KrazTech/SCAN2000-NO-MCU/images/Logic-Controlled.PNG

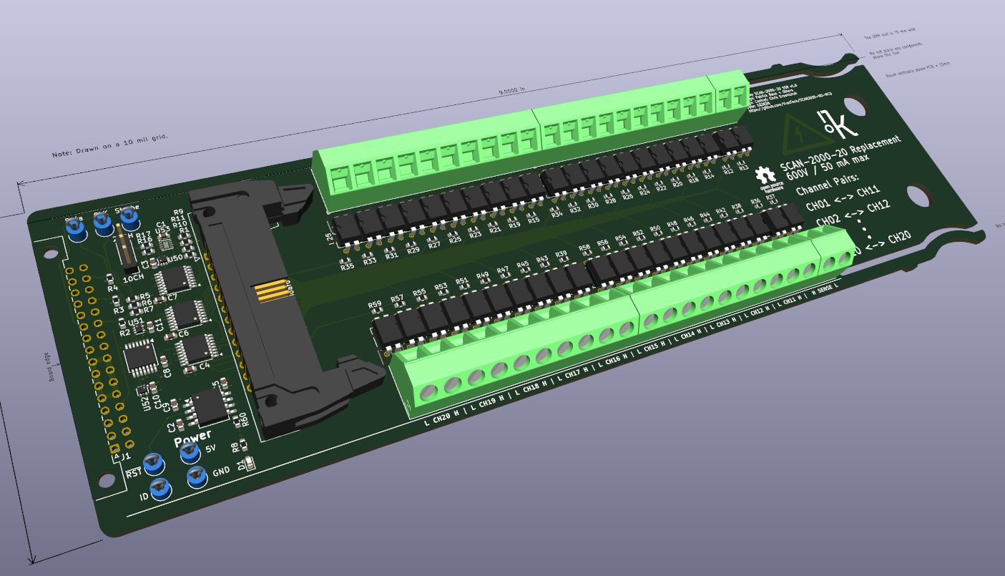
images/Logic-Controlled.PNG
