KrazTech/SCAN2000-NO-MCU/main.kicad_pcb

## KiCad design main.kicad_pcb (2026-03-02)

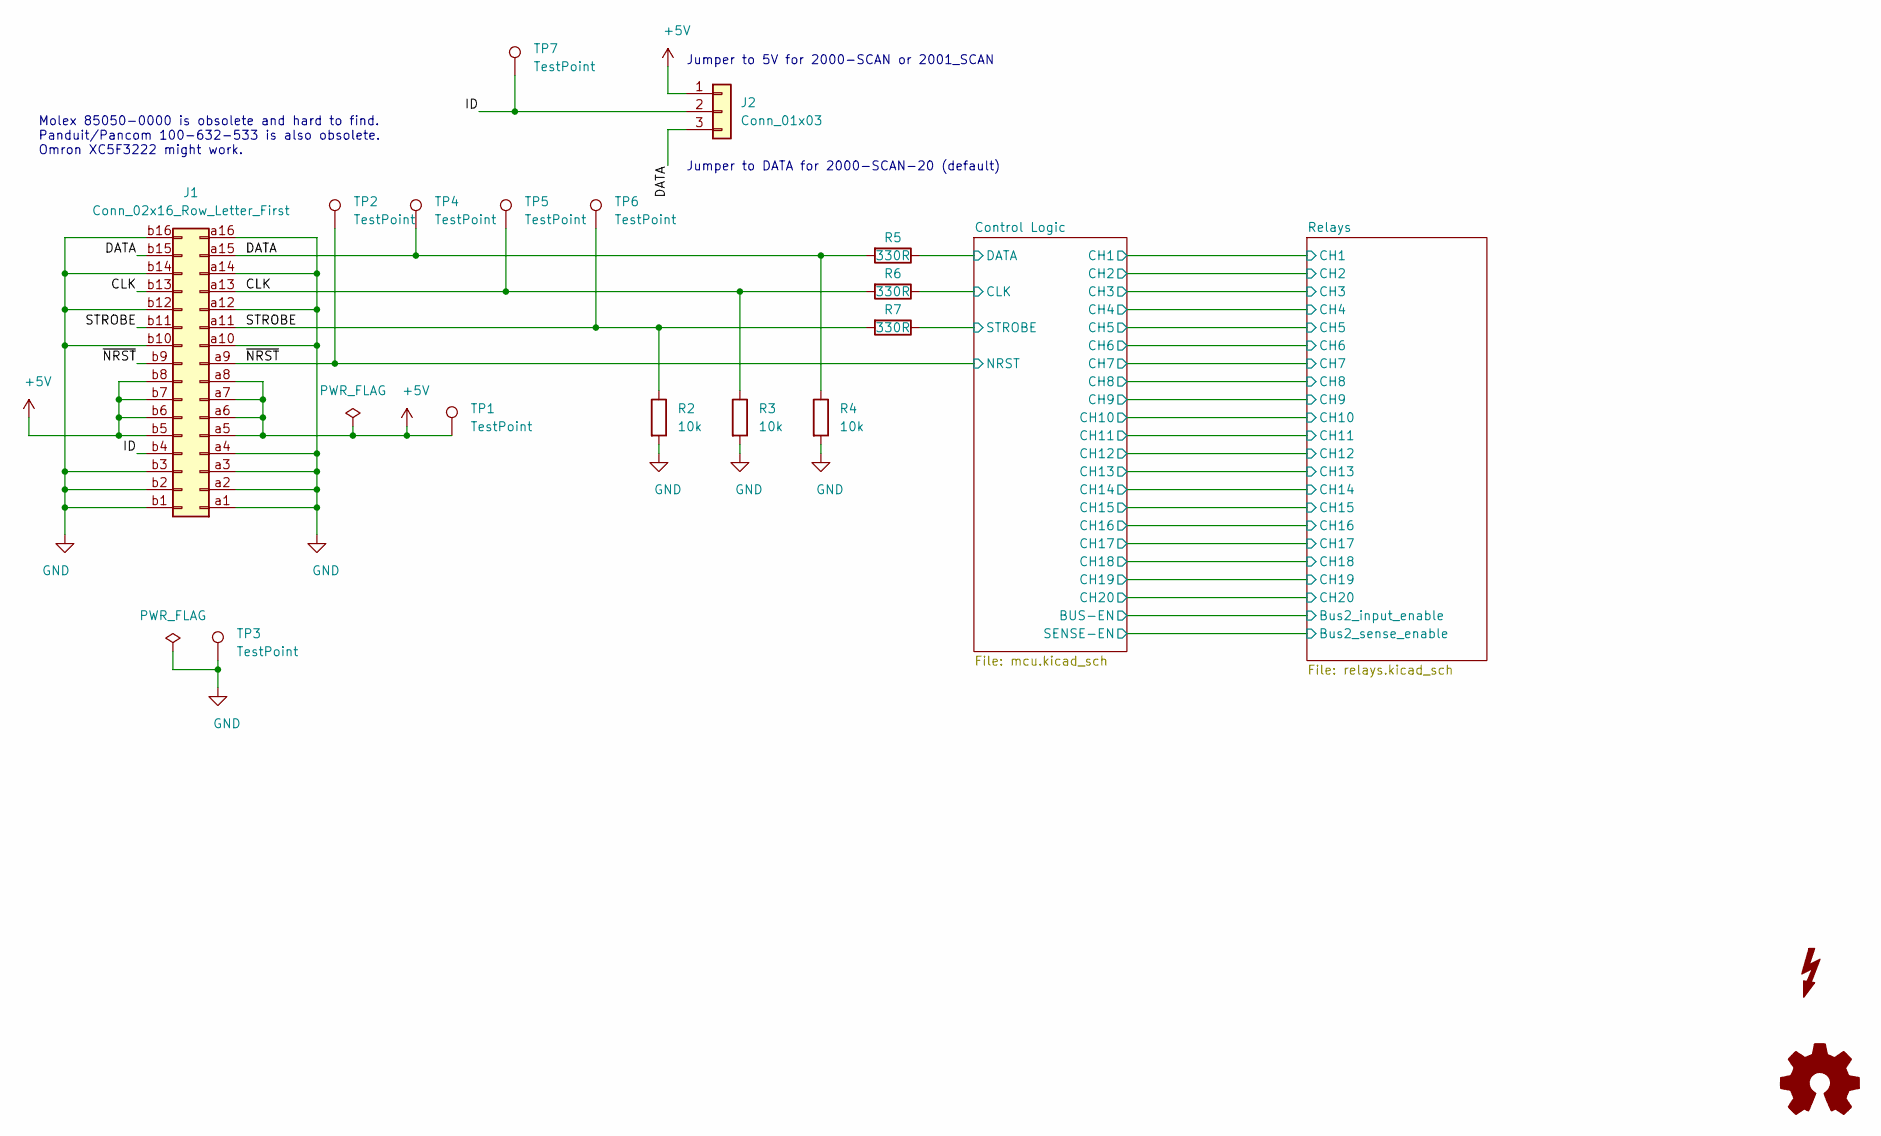
[picture p2: schematic main.kicad_sch, Keithley 2000-SCAN-20 SSR]

Parts:
J1: Conn_02x16_Row_Letter_First; DIN41612_B2_2x16_Male_Horizontal_THT
J2: Conn_01x03; PinHeader_1x03_P2.54mm_Vertical
LOGO2: Logo_Open_Hardware_Small; OSHW-Logo_7.5x8mm_SilkScreen
R2, R3, R4: 10k; R_0603_1608Metric
R5, R6, R7: 330R; R_0603_1608Metric
SYM1: SYM_Flash_Small; Symbol_Highvoltage_Type2_CopperTop_Small
TP1, TP2, TP3, TP4, TP5, TP6, TP7: TestPoint; TestPoint_Loop_D2.60mm_Drill1.6mm_Beaded

Connections:
+5V: J1.a5, J1.a6, J1.a7, J1.a8, J1.b5, J1.b6, J1.b7, J1.b8, J2.1, TP1.1; also elsewhere on the board
/CLK: J1.a13, J1.b13, R3.1, R6.2, TP5.1
/Control Logic/CLK: R6.1; also elsewhere on the board
/Control Logic/DATA: R5.1; also elsewhere on the board
/Control Logic/STROBE: R7.1; also elsewhere on the board
/DATA: J1.a15, J1.b15, J2.3, R4.1, R5.2, TP4.1
/ID: J1.b4, J2.2, TP7.1
/STROBE: J1.a11, J1.b11, R2.1, R7.2, TP6.1
/~NRST: J1.a9, J1.b9, TP2.1; also elsewhere on the board
GND: J1.a1, J1.a2, J1.a3, J1.a4, J1.a10, J1.a12, J1.a14, J1.a16, J1.b1, J1.b2, J1.b3, J1.b10, J1.b12, J1.b14, J1.b16, R2.2, R3.2, R4.2, TP3.1; also elsewhere on the board

Notes on the sheet:
Jumper to 5V for 2000-SCAN or 2001_SCAN
Molex 85050-0000 is obsolete and hard to find. Panduit/Pancom 100-632-533 is also obsolete. Omron XC5F3222 might work.
Jumper to DATA for 2000-SCAN-20 (default)

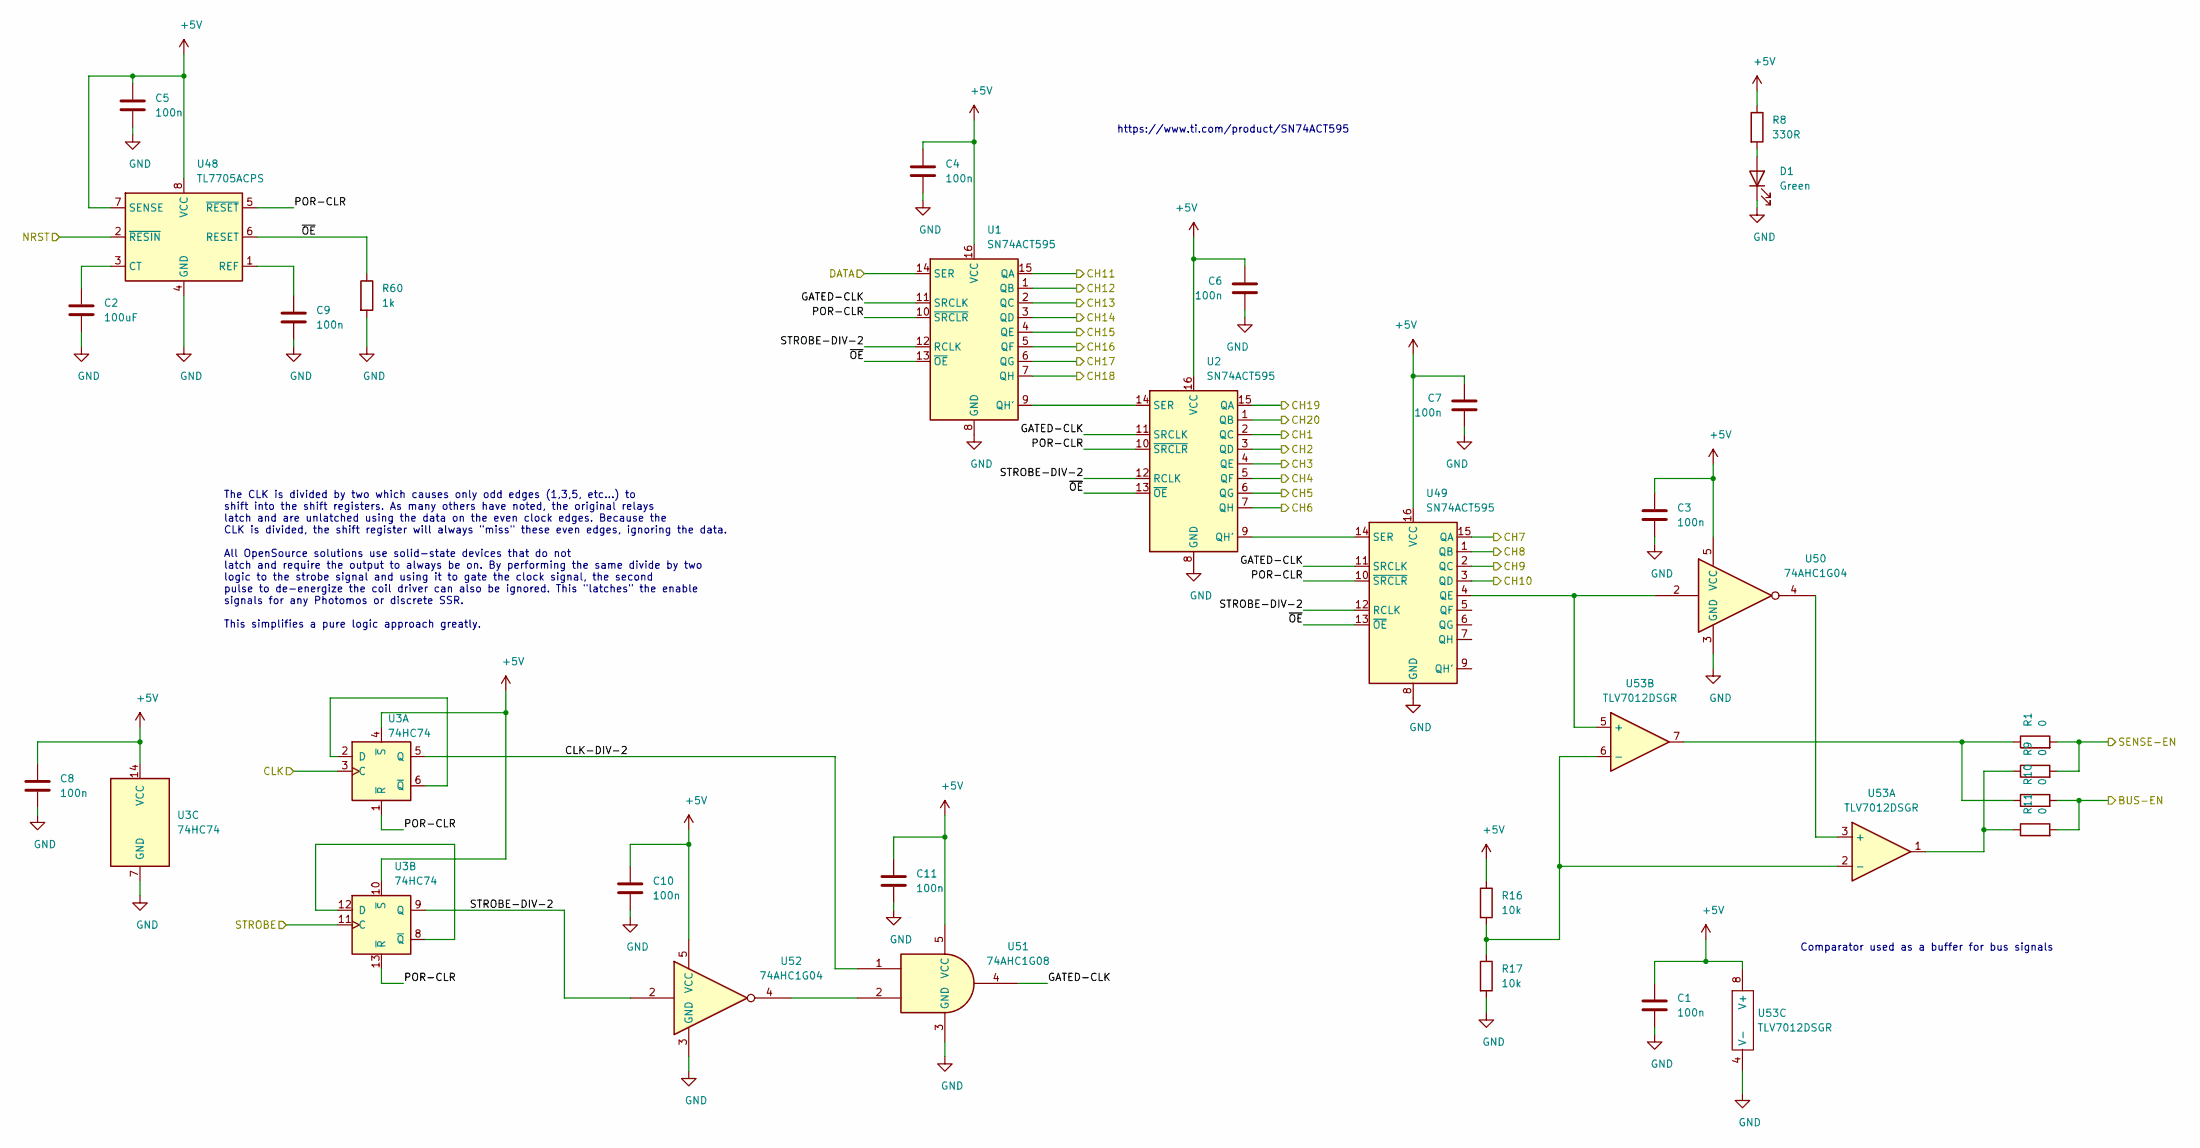
[picture p3: schematic mcu.kicad_sch, Keithley 2000-SCAN-20 SSR]

Parts:
C1, C3, C4, C5, C6, C7, C8, C9, C10, C11: 100n; C_0603_1608Metric
C2: 100uF; C_0603_1608Metric
D1: Green; LED_0603_1608Metric
R1, R9, R10, R11: 0; R_0603_1608Metric
R8: 330R; R_0603_1608Metric
R16, R17: 10k; R_0603_1608Metric
R60: 1k; R_0603_1608Metric
U1, U2, U49: SN74ACT595; TSSOP-16_4.4x5mm_P0.65mm
U3: 74HC74; TSSOP-14_4.4x5mm_P0.65mm
U48: TL7705ACPS; SOIC-8_5.3x6.2mm_P1.27mm
U50, U52: 74AHC1G04; SOT-553
U51: 74AHC1G08; SOT-553
U53: TLV7012DSGR; Texas_DSG0008A_WSON-8-1EP_2x2mm_P0.5mm_EP0.9x1.6mm_ThermalV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

Connections:
+5V: C1.1, C3.1, C4.1, C5.1, C6.1, C7.1, C8.1, C10.1, C11.1, R8.1, R16.1, U1.16 (VCC), U2.16 (VCC), U3.4 (~S), U3.10 (~S), U3.14 (VCC), U48.7 (SENSE), U48.8 (VCC), U49.16 (VCC), U50.5 (VCC), U51.5 (VCC), U52.5 (VCC), U53.8 (V+); also elsewhere on the board
/Control Logic/BUS-EN: R10.2, R11.2; also elsewhere on the board
/Control Logic/CH1: U2.2 (QC); also elsewhere on the board
/Control Logic/CH2: U2.3 (QD); also elsewhere on the board
/Control Logic/CH3: U2.4 (QE); also elsewhere on the board
/Control Logic/CH4: U2.5 (QF); also elsewhere on the board
/Control Logic/CH5: U2.6 (QG); also elsewhere on the board
/Control Logic/CH6: U2.7 (QH); also elsewhere on the board
/Control Logic/CH7: U49.15 (QA); also elsewhere on the board
/Control Logic/CH8: U49.1 (QB); also elsewhere on the board
/Control Logic/CH9: U49.2 (QC); also elsewhere on the board
/Control Logic/CH10: U49.3 (QD); also elsewhere on the board
/Control Logic/CH11: U1.15 (QA); also elsewhere on the board
/Control Logic/CH12: U1.1 (QB); also elsewhere on the board
/Control Logic/CH13: U1.2 (QC); also elsewhere on the board
/Control Logic/CH14: U1.3 (QD); also elsewhere on the board
/Control Logic/CH15: U1.4 (QE); also elsewhere on the board
/Control Logic/CH16: U1.5 (QF); also elsewhere on the board
/Control Logic/CH17: U1.6 (QG); also elsewhere on the board
/Control Logic/CH18: U1.7 (QH); also elsewhere on the board
/Control Logic/CH19: U2.15 (QA); also elsewhere on the board
/Control Logic/CH20: U2.1 (QB); also elsewhere on the board
/Control Logic/CLK: U3.3 (C); also elsewhere on the board
/Control Logic/CLK-DIV-2: U3.5 (Q), U51.1
/Control Logic/DATA: U1.14 (SER); also elsewhere on the board
/Control Logic/GATED-CLK: U1.11 (SRCLK), U2.11 (SRCLK), U49.11 (SRCLK), U51.4
/Control Logic/POR-CLR: U1.10 (~SRCLR), U2.10 (~SRCLR), U3.1 (~R), U3.13 (~R), U48.5 (~RESET), U49.10 (~SRCLR)
/Control Logic/SENSE-EN: R1.2, R9.2; also elsewhere on the board
/Control Logic/STROBE: U3.11 (C); also elsewhere on the board
/Control Logic/STROBE-DIV-2: U1.12 (RCLK), U2.12 (RCLK), U3.9 (Q), U49.12 (RCLK), U52.2
/Control Logic/~OE: R60.1, U1.13 (~OE), U2.13 (~OE), U48.6 (RESET), U49.13 (~OE)
/~NRST: U48.2 (~RESIN); also elsewhere on the board
GND: C1.2, C2.2, C3.2, C4.2, C5.2, C6.2, C7.2, C8.2, C9.2, C10.2, C11.2, D1.1 (K), R17.2, R60.2, U1.8 (GND), U2.8 (GND), U3.7 (GND), U48.4 (GND), U49.8 (GND), U50.3 (GND), U51.3 (GND), U52.3 (GND), U53.4 (V-); also elsewhere on the board
unnamed: D1.2 (A), R8.2
unnamed: R1.1, R10.1, U53.7
unnamed: R9.1, R11.1, U53.1
unnamed: U1.9 (QH'), U2.14 (SER)
unnamed: U2.9 (QH'), U49.14 (SER)
unnamed: U3.2 (D), U3.6 (~Q)
unnamed: U3.8 (~Q), U3.12 (D)
unnamed: C2.1, U48.3 (CT)
unnamed: C9.1, U48.1 (REF)
unnamed: U49.4 (QE), U50.2, U53.5 (+)
unnamed: U51.2, U52.4
unnamed: U50.4, U53.3 (+)
unnamed: R16.2, R17.1, U53.2 (-), U53.6 (-)

Notes on the sheet:
The CLK is divided by two which causes only odd edges (1,3,5, etc...) to shift into the shift registers. As many others have noted, the original relays latch and are unlatched using the data on the even clock edges. Because the CLK is divided, the shift register will always "miss" these even edges,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
https://www.ti.com/product/SN74ACT595
Comparator used as a buffer for bus signals

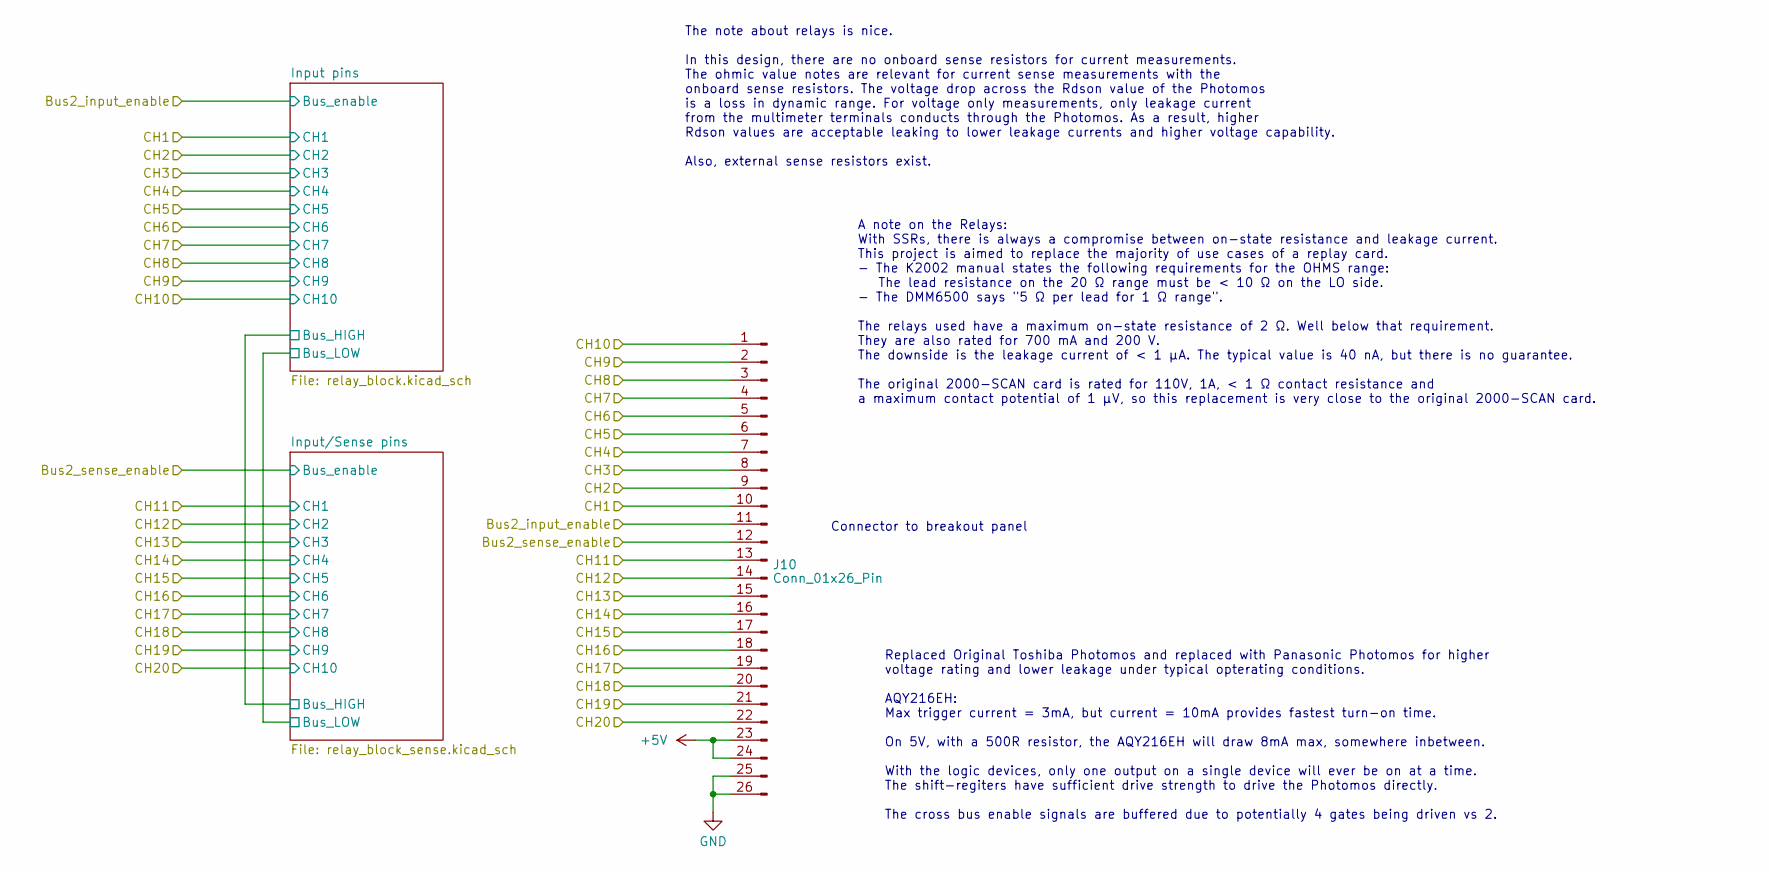
[picture p4: schematic relays.kicad_sch, Keithley 2000-SCAN-20 SSR]

Parts:
J10: Conn_01x26_Pin; IDC-Header_2x13_P2.54mm_Latch_Horizontal

Connections:
+5V: J10.23, J10.24; also elsewhere on the board
/Control Logic/BUS-EN: J10.11; also elsewhere on the board
/Control Logic/CH1: J10.10; also elsewhere on the board
/Control Logic/CH2: J10.9; also elsewhere on the board
/Control Logic/CH3: J10.8; also elsewhere on the board
/Control Logic/CH4: J10.7; also elsewhere on the board
/Control Logic/CH5: J10.6; also elsewhere on the board
/Control Logic/CH6: J10.5; also elsewhere on the board
/Control Logic/CH7: J10.4; also elsewhere on the board
/Control Logic/CH8: J10.3; also elsewhere on the board
/Control Logic/CH9: J10.2; also elsewhere on the board
/Control Logic/CH10: J10.1; also elsewhere on the board
/Control Logic/CH11: J10.13; also elsewhere on the board
/Control Logic/CH12: J10.14; also elsewhere on the board
/Control Logic/CH13: J10.15; also elsewhere on the board
/Control Logic/CH14: J10.16; also elsewhere on the board
/Control Logic/CH15: J10.17; also elsewhere on the board
/Control Logic/CH16: J10.18; also elsewhere on the board
/Control Logic/CH17: J10.19; also elsewhere on the board
/Control Logic/CH18: J10.20; also elsewhere on the board
/Control Logic/CH19: J10.21; also elsewhere on the board
/Control Logic/CH20: J10.22; also elsewhere on the board
/Control Logic/SENSE-EN: J10.12; also elsewhere on the board
GND: J10.25, J10.26; also elsewhere on the board

Notes on the sheet:
A note on the Relays: With SSRs, there is always a compromise between on-state resistance and leakage current. This project is aimed to replace the majority of use cases of a replay card. - The K2002 manual states the following requirements for the OHMS range: The lead resistance on the 20 Ω range 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
Replaced Original Toshiba Photomos and replaced with Panasonic Photomos for higher voltage rating and lower leakage under typical opterating conditions. AQY216EH: Max trigger current = 3mA, but current = 10mA provides fastest turn-on time. On 5V, with a 500R resistor, the AQY216EH will draw 8mA max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
The note about relays is nice. In this design, there are no onboard sense resistors for current measurements. The ohmic value notes are relevant for current sense measurements with the onboard sense resistors. The voltage drop across the Rdson value of the Photomos is a loss in dynamic range. For v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
Connector to breakout panel

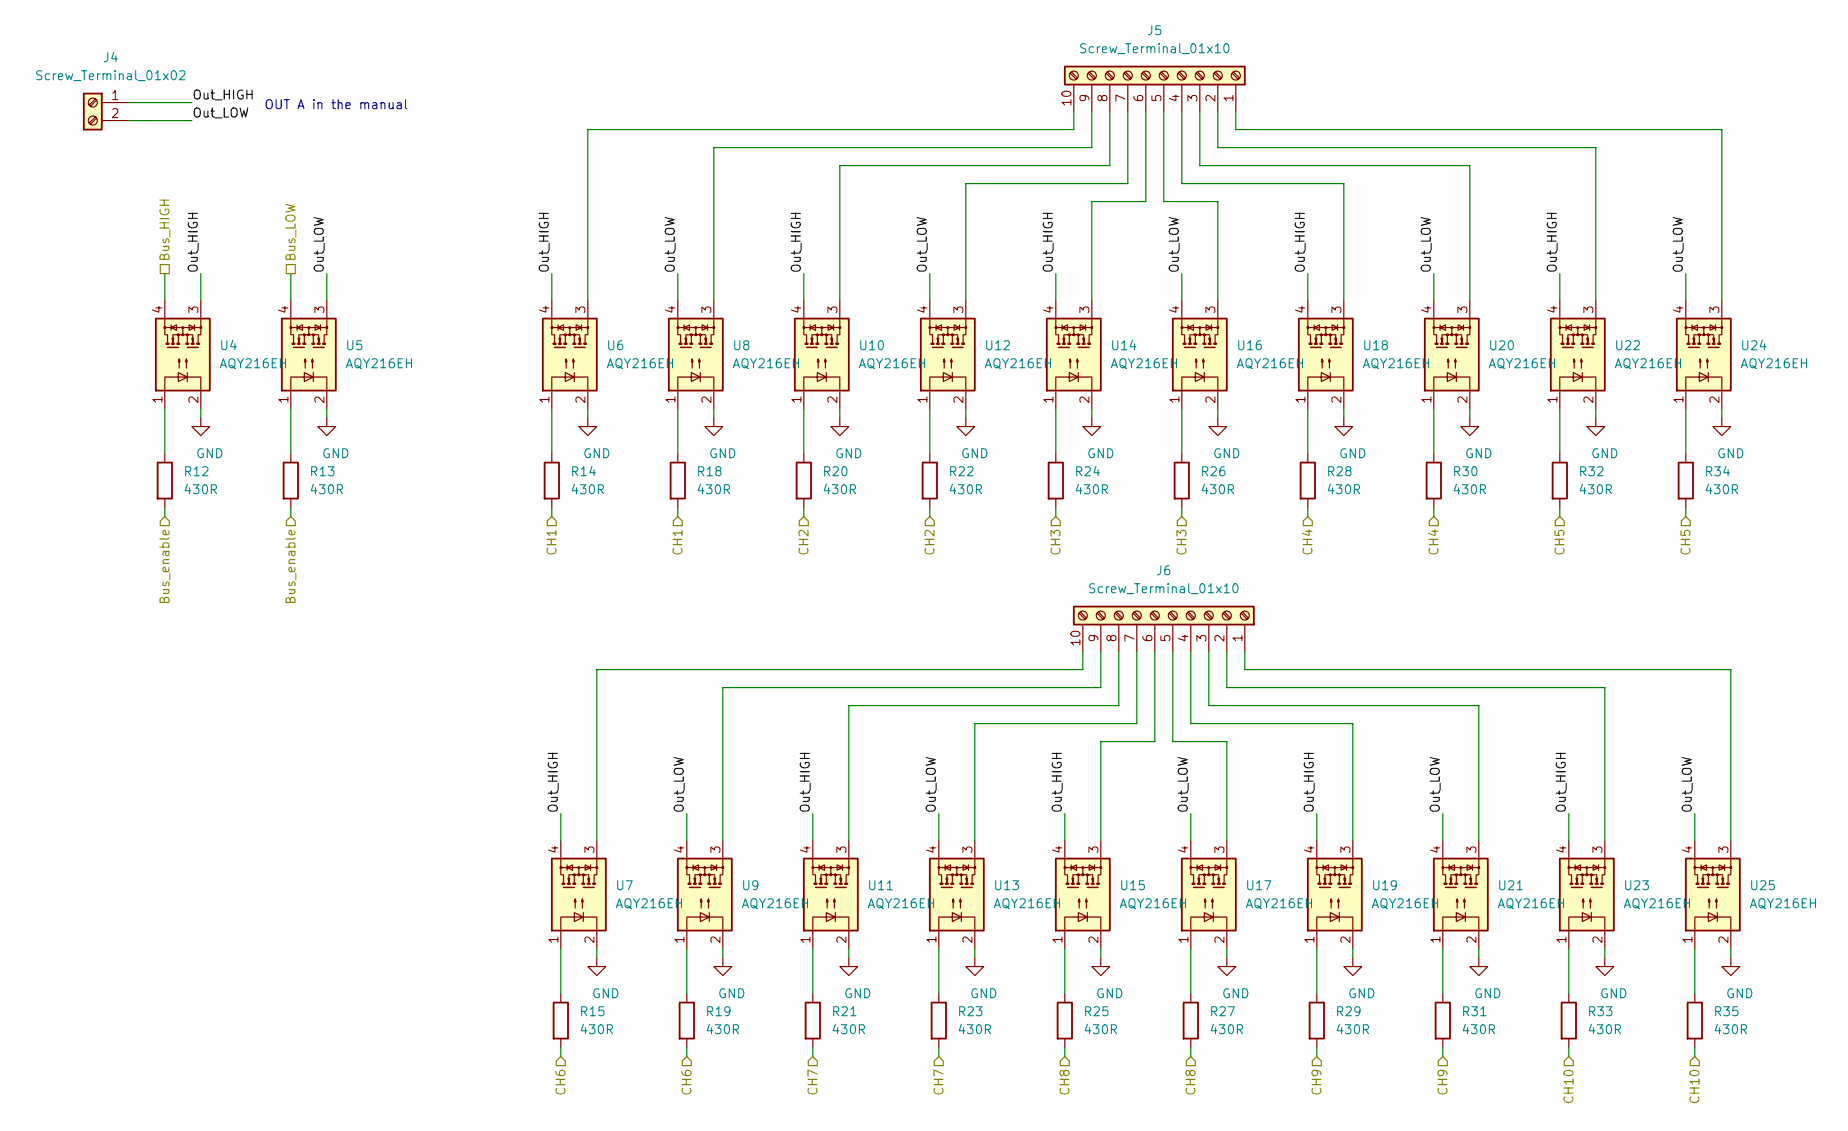
[picture p5: schematic relay_block.kicad_sch, Keithley 2000-SCAN-20 SSR]

Parts:
J4: Screw_Terminal_01x02; TerminalBlock_Phoenix_SMKDSN-1,5-2-5.08_1x02_P5.08mm_Horizo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
J5, J6: Screw_Terminal_01x10; TerminalBlock_Phoenix_SMKDSN-1,5-10-5.08_1x10_P5.08mm_Horiz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
R12, R13, R14, R15, R18, R19, R20, R21, R22, R23, R24, R25, R26, R27, R28, R29, R30, R31, R32, R33, R34, R35: 430R; R_0603_1608Metric
U4, U5, U6, U7, U8, U9, U10, U11, U12, U13, U14, U15, U16, U17, U18, U19, U20, U21, U22, U23, U24, U25: AQY216EH; DIP-4_W7.62mm_Least

Connections:
/Control Logic/BUS-EN: R12.2, R13.2; also elsewhere on the board
/Control Logic/CH1: R14.2, R18.2; also elsewhere on the board
/Control Logic/CH2: R20.2, R22.2; also elsewhere on the board
/Control Logic/CH3: R24.2, R26.2; also elsewhere on the board
/Control Logic/CH4: R28.2, R30.2; also elsewhere on the board
/Control Logic/CH5: R32.2, R34.2; also elsewhere on the board
/Control Logic/CH6: R15.2, R19.2; also elsewhere on the board
/Control Logic/CH7: R21.2, R23.2; also elsewhere on the board
/Control Logic/CH8: R25.2, R27.2; also elsewhere on the board
/Control Logic/CH9: R29.2, R31.2; also elsewhere on the board
/Control Logic/CH10: R33.2, R35.2; also elsewhere on the board
/Relays/Input pins/Bus_HIGH: U4.4; also elsewhere on the board
/Relays/Input pins/Bus_LOW: U5.4; also elsewhere on the board
/Relays/Input pins/Out_HIGH: J4.1, U4.3, U6.4, U7.4, U10.4, U11.4, U14.4, U15.4, U18.4, U19.4, U22.4, U23.4
/Relays/Input pins/Out_LOW: J4.2, U5.3, U8.4, U9.4, U12.4, U13.4, U16.4, U17.4, U20.4, U21.4, U24.4, U25.4
GND: U4.2, U5.2, U6.2, U7.2, U8.2, U9.2, U10.2, U11.2, U12.2, U13.2, U14.2, U15.2, U16.2, U17.2, U18.2, U19.2, U20.2, U21.2, U22.2, U23.2, U24.2, U25.2; also elsewhere on the board
unnamed: J5.1, U24.3
unnamed: J5.2, U22.3
unnamed: J5.3, U20.3
unnamed: J5.4, U18.3
unnamed: J5.5, U16.3
unnamed: J5.6, U14.3
unnamed: J5.7, U12.3
unnamed: J5.8, U10.3
unnamed: J5.9, U8.3
unnamed: J5.10, U6.3
unnamed: J6.1, U25.3
unnamed: J6.2, U23.3
unnamed: J6.3, U21.3
unnamed: J6.4, U19.3
unnamed: J6.5, U17.3
unnamed: J6.6, U15.3
unnamed: J6.7, U13.3
unnamed: J6.8, U11.3
unnamed: J6.9, U9.3
unnamed: J6.10, U7.3
unnamed: R12.1, U4.1
unnamed: R13.1, U5.1
unnamed: R14.1, U6.1
unnamed: R15.1, U7.1
unnamed: R18.1, U8.1
unnamed: R19.1, U9.1
unnamed: R20.1, U10.1
unnamed: R21.1, U11.1
unnamed: R22.1, U12.1
unnamed: R23.1, U13.1
unnamed: R24.1, U14.1
unnamed: R25.1, U15.1
unnamed: R26.1, U16.1
unnamed: R27.1, U17.1
unnamed: R28.1, U18.1
unnamed: R29.1, U19.1
unnamed: R30.1, U20.1
unnamed: R31.1, U21.1
unnamed: R32.1, U22.1
unnamed: R33.1, U23.1
unnamed: R34.1, U24.1
unnamed: R35.1, U25.1

Notes on the sheet:
OUT A in the manual

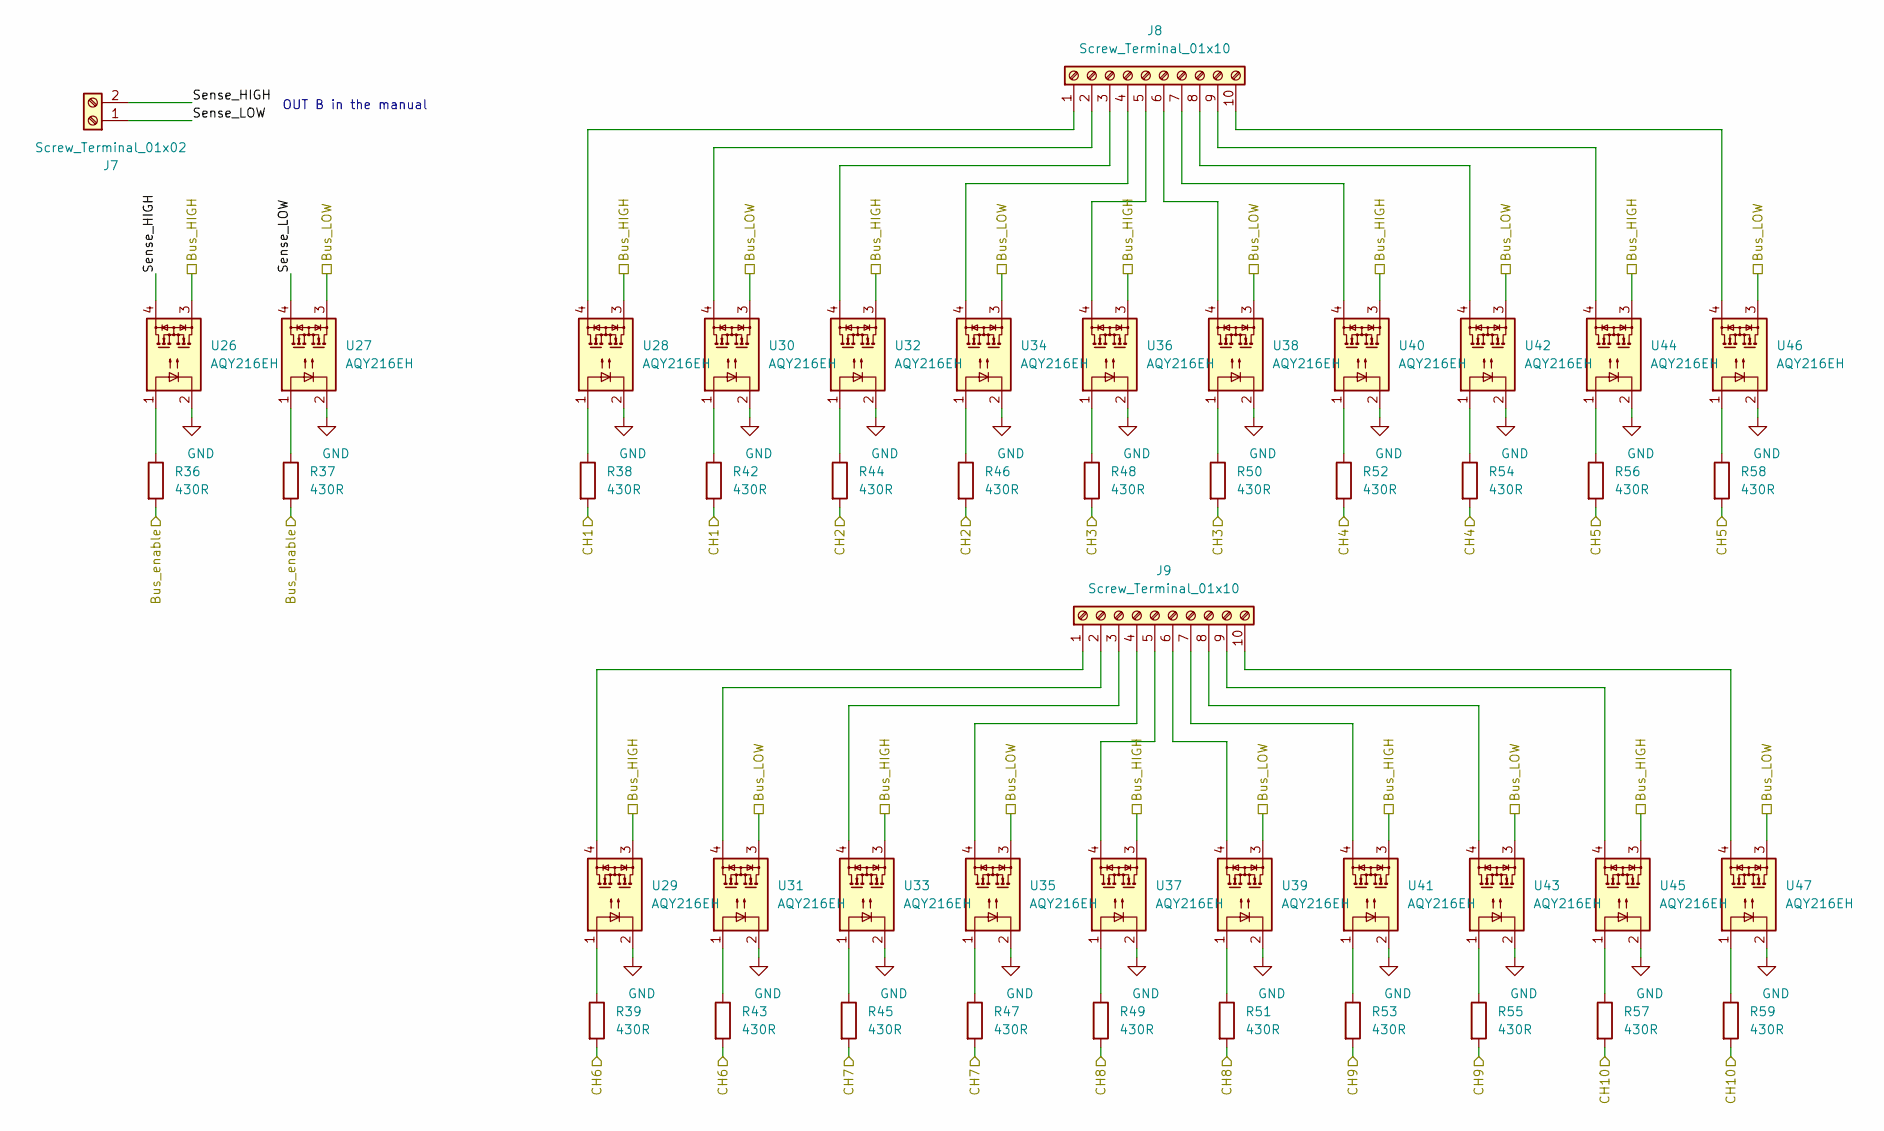
[picture p6: schematic relay_block_sense.kicad_sch, Keithley 2000-SCAN-20 SSR]

Parts:
J7: Screw_Terminal_01x02; TerminalBlock_Phoenix_SMKDSN-1,5-2-5.08_1x02_P5.08mm_Horizo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
J8, J9: Screw_Terminal_01x10; TerminalBlock_Phoenix_SMKDSN-1,5-10-5.08_1x10_P5.08mm_Horiz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
R36, R37, R38, R39, R42, R43, R44, R45, R46, R47, R48, R49, R50, R51, R52, R53, R54, R55, R56, R57, R58, R59: 430R; R_0603_1608Metric
U26, U27, U28, U29, U30, U31, U32, U33, U34, U35, U36, U37, U38, U39, U40, U41, U42, U43, U44, U45, U46, U47: AQY216EH; DIP-4_W7.62mm_Least

Connections:
/Control Logic/CH11: R38.2, R42.2; also elsewhere on the board
/Control Logic/CH12: R44.2, R46.2; also elsewhere on the board
/Control Logic/CH13: R48.2, R50.2; also elsewhere on the board
/Control Logic/CH14: R52.2, R54.2; also elsewhere on the board
/Control Logic/CH15: R56.2, R58.2; also elsewhere on the board
/Control Logic/CH16: R39.2, R43.2; also elsewhere on the board
/Control Logic/CH17: R45.2, R47.2; also elsewhere on the board
/Control Logic/CH18: R49.2, R51.2; also elsewhere on the board
/Control Logic/CH19: R53.2, R55.2; also elsewhere on the board
/Control Logic/CH20: R57.2, R59.2; also elsewhere on the board
/Control Logic/SENSE-EN: R36.2, R37.2; also elsewhere on the board
/Relays/Input pins/Bus_HIGH: U26.3, U28.3, U29.3, U32.3, U33.3, U36.3, U37.3, U40.3, U41.3, U44.3, U45.3; also elsewhere on the board
/Relays/Input pins/Bus_LOW: U27.3, U30.3, U31.3, U34.3, U35.3, U38.3, U39.3, U42.3, U43.3, U46.3, U47.3; also elsewhere on the board
/Relays/Input/Sense pins/Sense_HIGH: J7.2, U26.4
/Relays/Input/Sense pins/Sense_LOW: J7.1, U27.4
GND: U26.2, U27.2, U28.2, U29.2, U30.2, U31.2, U32.2, U33.2, U34.2, U35.2, U36.2, U37.2, U38.2, U39.2, U40.2, U41.2, U42.2, U43.2, U44.2, U45.2, U46.2, U47.2; also elsewhere on the board
unnamed: J8.1, U28.4
unnamed: J8.2, U30.4
unnamed: J8.3, U32.4
unnamed: J8.4, U34.4
unnamed: J8.5, U36.4
unnamed: J8.6, U38.4
unnamed: J8.7, U40.4
unnamed: J8.8, U42.4
unnamed: J8.9, U44.4
unnamed: J8.10, U46.4
unnamed: J9.1, U29.4
unnamed: J9.2, U31.4
unnamed: J9.3, U33.4
unnamed: J9.4, U35.4
unnamed: J9.5, U37.4
unnamed: J9.6, U39.4
unnamed: J9.7, U41.4
unnamed: J9.8, U43.4
unnamed: J9.9, U45.4
unnamed: J9.10, U47.4
unnamed: R36.1, U26.1
unnamed: R37.1, U27.1
unnamed: R38.1, U28.1
unnamed: R39.1, U29.1
unnamed: R42.1, U30.1
unnamed: R43.1, U31.1
unnamed: R44.1, U32.1
unnamed: R45.1, U33.1
unnamed: R46.1, U34.1
unnamed: R47.1, U35.1
unnamed: R48.1, U36.1
unnamed: R49.1, U37.1
unnamed: R50.1, U38.1
unnamed: R51.1, U39.1
unnamed: R52.1, U40.1
unnamed: R53.1, U41.1
unnamed: R54.1, U42.1
unnamed: R55.1, U43.1
unnamed: R56.1, U44.1
unnamed: R57.1, U45.1
unnamed: R58.1, U46.1
unnamed: R59.1, U47.1

Notes on the sheet:
OUT B in the manual

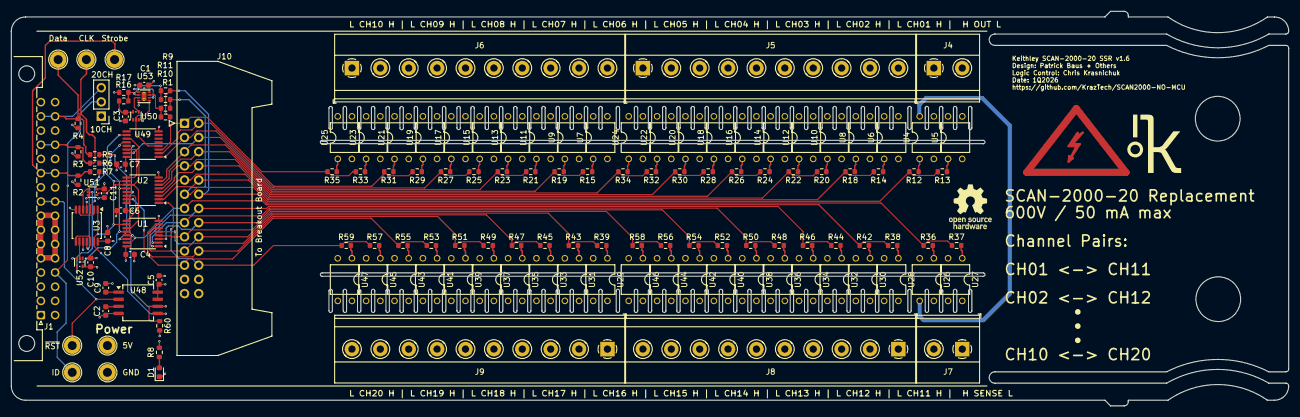
[picture p7: board main.kicad_pcb from above]

Board: 4 copper layers, 228.6 x 70.6 mm, 141 parts (0 on the bottom side), 140 nets.
