KrazTech/SCAN2000-NO-MCU/(commit log)

2026-03-02 Version 1.6
    Created a high-voltage rated scan board.
    Control is done completely in logic to avoid programming an MCU
    [main.kicad_pcb, main.kicad_sch, mcu.kicad_sch, relay_block.kicad_sch, relay_block_sense.kicad_sch, relays.kicad_sch]
2026-03-02 Added Image
    [main.kicad_pcb, mcu.kicad_sch]
