KrazTech/SCAN2000-NO-MCU/(notices)

Notices in the files:
main.kicad_sch:
Copyright (©) 2021, Patrick Baus
Licensed under CERN OHL v.1.2
mcu.kicad_sch:
Copyright (©) 2026, Chris Krasnichuk
